Elmira-Athena/SATX-2026/Mục yêu cầu SATx/Cấu hình chân  IO.pdf

NGUỒN | ESP32

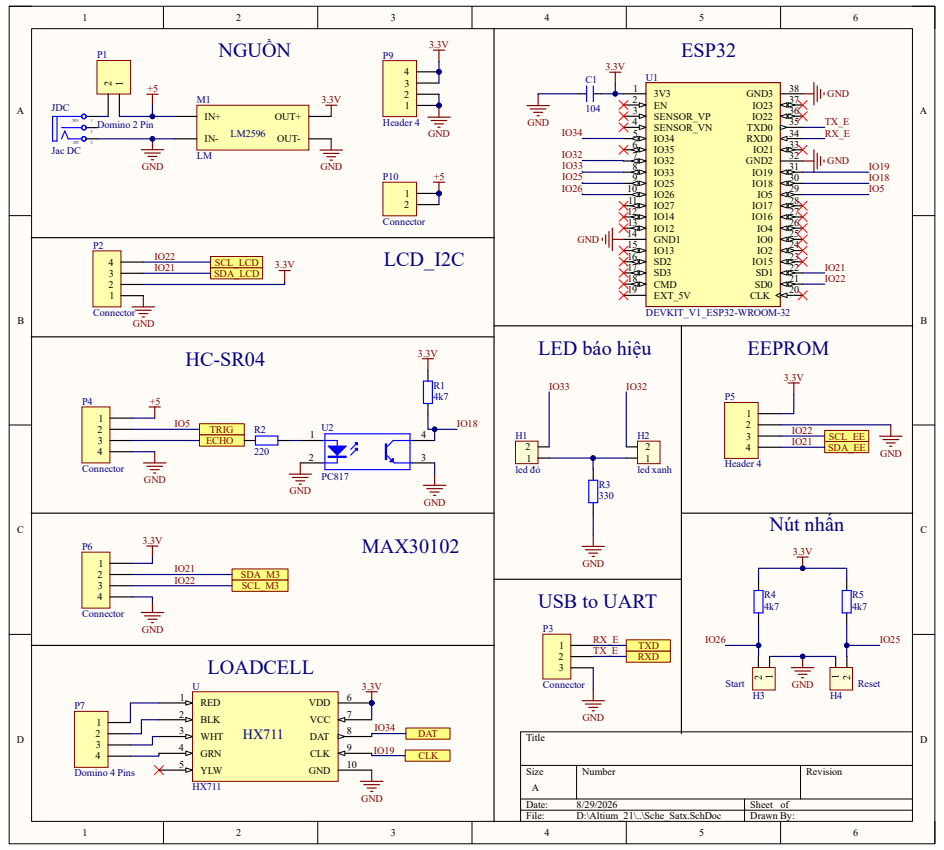
[picture p59: page 1]
